BatrinutSilviu/Licenta/README.md

# Licenta
Licenta
Robot biped comandat manual sau automat
