BatrinutSilviu/Licenta/ROBOTINHO2.pptx

## ROBOTINHO Robot Umanoid autonom pentru Urmărirea obiectelor

Coordonator: Ș.l.dr.ing. Sorin NANU Student: Silviu BĂTRÎNUȚ

## Tema proiectului

Implementarea unui algoritm de căutare a unei mingi și de șutare în aceasta
Posibilitatea de control manual prin intermediul unei aplicații mobile

## Cuprins

- Arhitectura sistemului
- Funcțiile sistemului
- Unelte Hardware
- Unelte Software
- Probleme întâmpinate
- Dezvoltări viitoare
- Concluzii

## Arhitectura sistemului

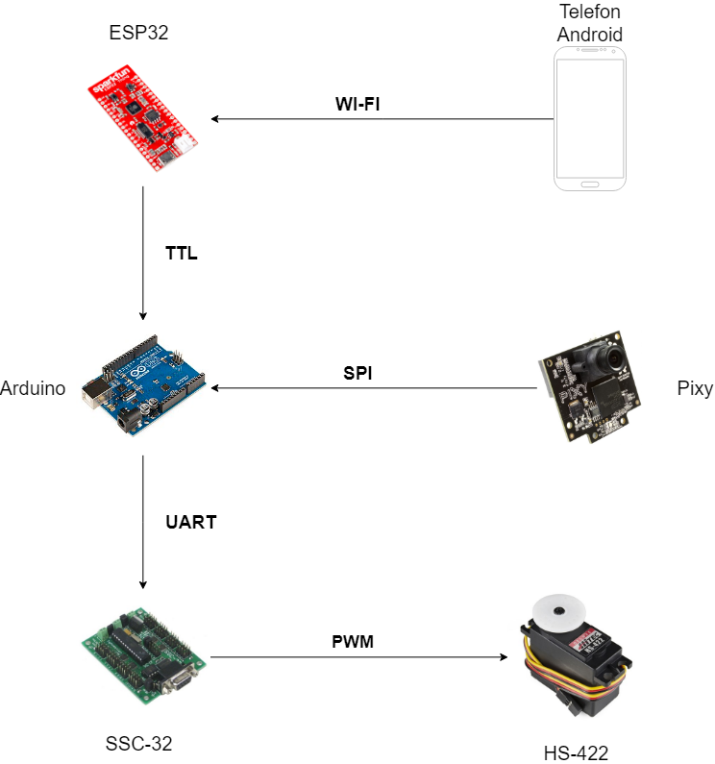
[picture p1: figure]

Silviu

Daniel

Ambii

## Funcțiile sistemului

Comandă automată
Deplasarea în orice direcție
Lovirea obiectului cu ambele picioare
Comandă manuală
Deplasarea în orice direcție
Detecția mingii
Lovirea obiectului cu ambele picioare
Rularea unui scurt dans

## Hardware (1)

Placă SSC32
6 motoare HS-442
Placă Arduino Uno

## Hardware (2)

Placă ESP-32 Thing
Cameră Pixy CMUcam5
Sursă de tensiune electrică

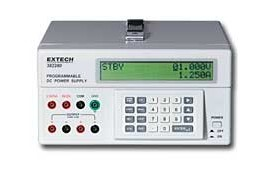
[picture p2: figure]

## Unelte Software

Arduino IDE – C++
Android Studio – Java
GitHub
LynxTerm

## Aplicația Arduino

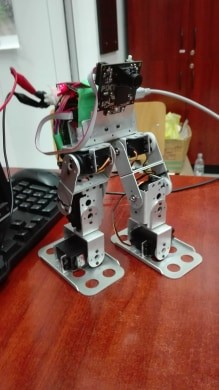
[picture p3: figure]
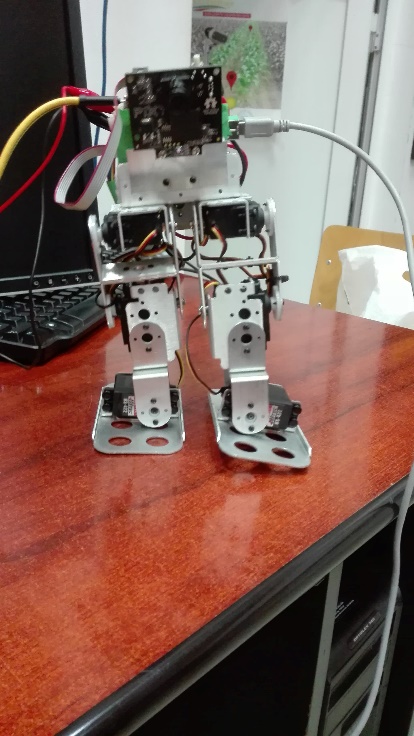
[picture p4: figure]

- Mișcare în lateral
- Întoarcere 90° stânga
- #18 P1500 T500

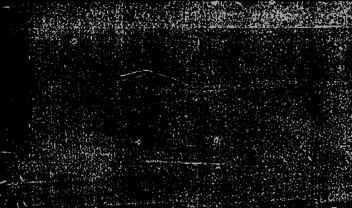
[picture p5: figure]

## Aplicația Android

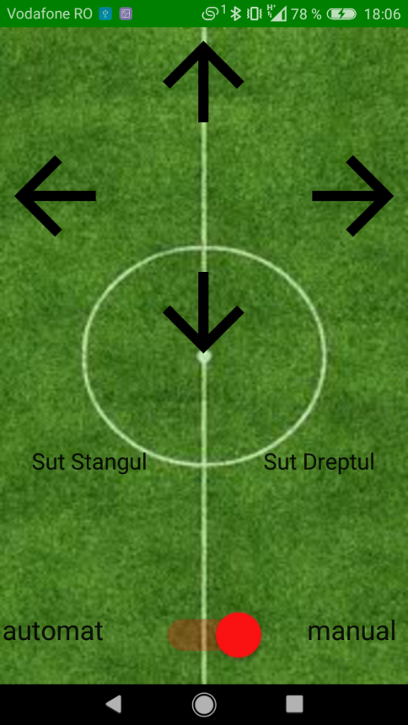
[picture p6: figure]

- Comenzi pentru deplasare
- Comenzi pentru șut
- Comandă pentru schimbarea modului de control

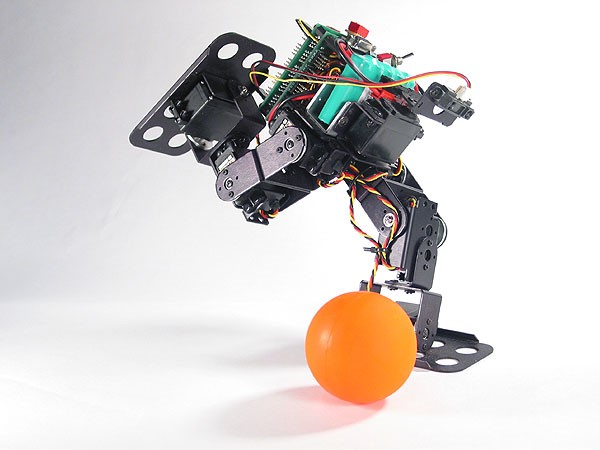
[picture p7: figure]

## Aplicația ESP32

Folosit ca server web
Recepționează cereri HTTP
Transmite mesaje la Arduino

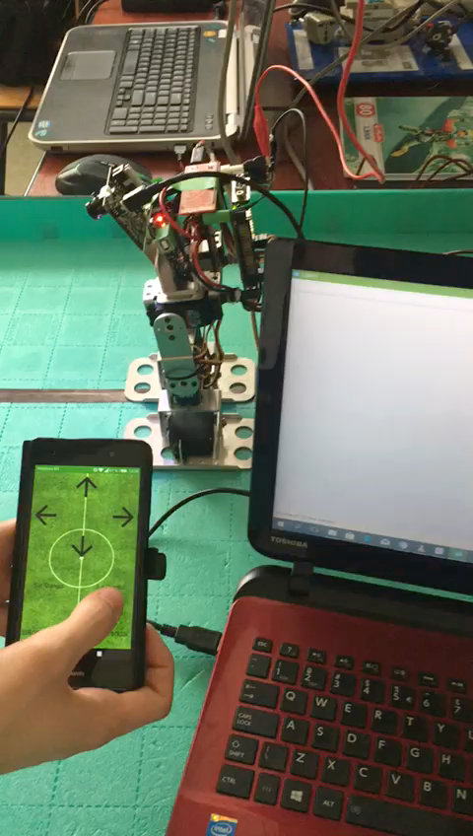
[picture p8: figure]

## Probleme întâmpinate

Echilibru robot
Încercări modul Bluetooth
Gestionarea cablurilor
Referințe diferite ale motoarelor

## Dezvoltări viitoare

Noi funcționalități
- Marcarea unui gol într-o poartă
- Interacțiunea cu alți roboți
Estetizarea ansamblului
Montarea unei baterii

## Concluzii

Proiect interesant și antrenant
Dezvoltare profesională
Aplicarea cunoștințelor dobândite la facultate

## Slide 15

Vă mulțumesc pentru atenție!
