BatrinutSilviu/Licenta/PPT DANI.pptx

## ROBOTINHO ROBOT UMANOID AUTONOM PENTRU URMĂrirea OBIECTELOR

Coordonator: Ș.l.dr.ing. Sorin NANU Studenti: DANIEL-Pavel NEAmțiu
Silviu-Dumitru BĂTRÎNUȚ

## Slide 2

Tema proiectului
Realizarea unui algoritm pentru detectarea, urmărirea și lovirea unei mingi
Controlarea manuală a robotului utilizând o aplicație mobilă

## Diagrama de ansamblu a Sistemului


## Funcțiile sistemului

Modul autonom
Detectarea obiectului
Deplasarea către obiect
Modul comandat manual
Capacitatea de a reproduce mișcările robotului:
Lovirea obiectului cu unul dintre picioare
Deplasare în față/spate
Întoarcere la stânga/dreapta
Șut cu piciorul stâng/drept

## Echipamente hardware

Placă ArduinoUNO
Procesare informații Pixy
Algoritm detecție și decizie
Cameră Pixy CMUcam5
Procesare imagine
Placă SSC-32
Control servo-motoare
Procesare comenzi ESP-32

## Echipamente hardware

Placă ESP-32
Recepție comenzi de la aplicația mobilă
Servo-motor HS-442
Mișcarea membrelor robotului
PC
Stocarea și utilizarea programelor auxiliare: PixyMon, LynxTerm
Transmisie comenzi către Arduino
Programarea aplicațiilor: ArduinoIDE, Android Studio
Alimentarea plăcii SSC-32 și a motoarelor
Sursă de tensiune Extech 382280

## Tehnologii software utilizate

Arduino IDE – C/C++
PixyMon

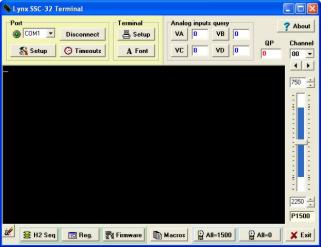
[picture p9: figure]
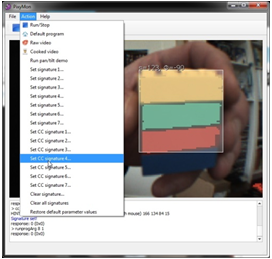
[picture p10: figure]

LynxTerm
GitHub

## Aplicație

Mod comandat manual
Procesarea comenzilor de la aplicația mobilă
Executarea comenzilor

Mod autonom
Algortim detecție
Algoritm decizional
Execuție mișcări

## Aplicație

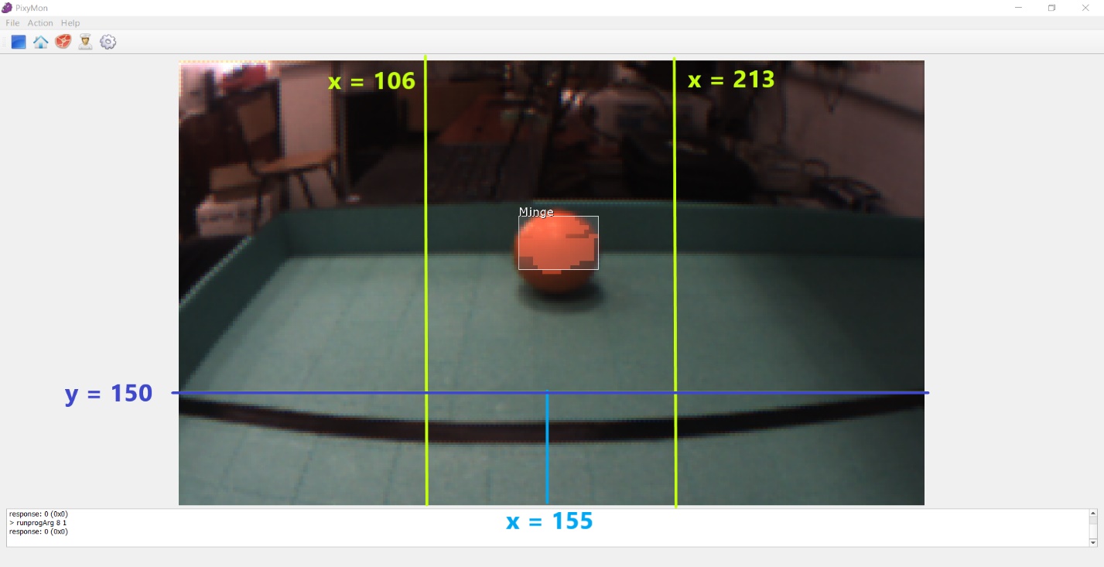
[picture p11: figure]
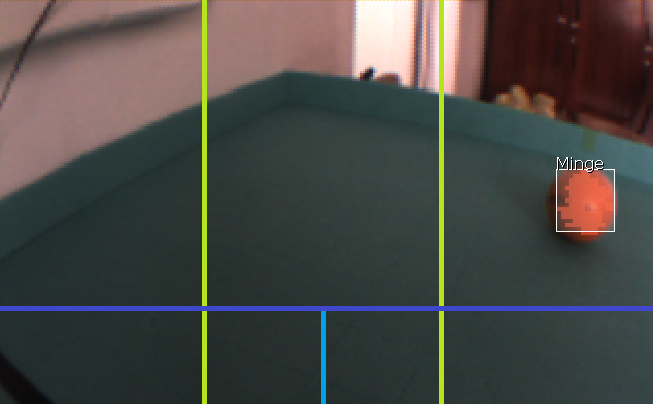
[picture p12: figure]

## Aplicație

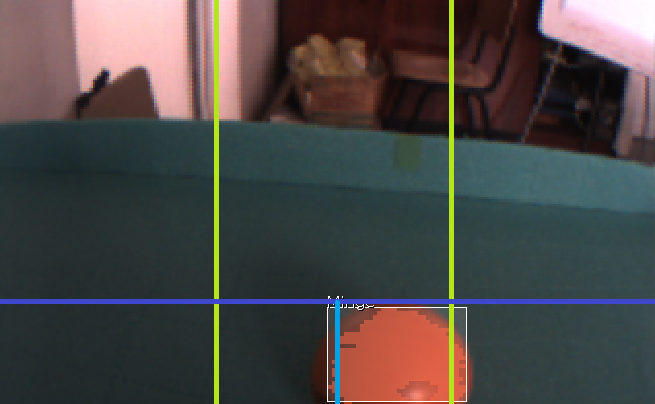
[picture p13: figure]
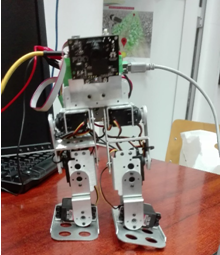
[picture p14: figure]

Mișcări
Deplasare în față
Deplasare în spate
Șut cu piciorul stâng
Șut cu piciorul drept

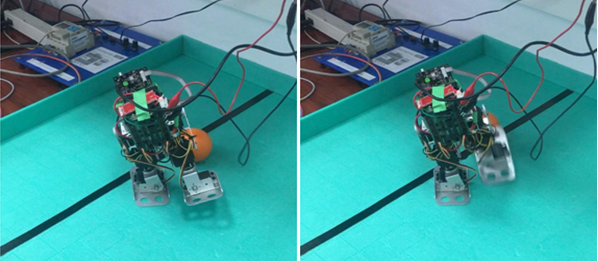
[picture p15: figure]

## Probleme Întâmpinate

Lumina ambientală diferită
Pas robot
Echilibru robot
Frecarea cu suprafața
Interconectarea modulelor

## Dezvoltări viitoare

Căutarea altor tipuri de obiecte
Optimizarea algoritmului de căutare
Alimentarea de la o baterie
Recunoașterea unor coduri de culori

## Concluzii

Dezvoltarea capacităților de lucru în echipă
Aplicarea cunoștințelor dobândite în cadrul facultăți
Dezvoltare profesională
Proiect antrenant și interesant

## VĂ Mulțumesc Pentru Atenția Acordată!
